sdsmt-robotics/power-distribution-board/README.md

# power-distribution-board
kicad files for a power distribution board
