sdsmt-robotics/power-distribution-board/Production/MinesRobotics_PDB.csv

Item | Qty | Reference(s) | Value | Footprint | MFN#
1 | 2 | C1, C7 | 10u | Capacitor_SMD:C_0603_1608Metric | GRM188R6YA106MA73D
2 | 1 | C2 | 0.1u | Capacitor_SMD:C_0603_1608Metric | CL10B104KB8WPND
3 | 2 | C3, C5 | 22u | Capacitor_Tantalum_SMD:CP_EIA-7343-15_Kemet-W | TCJD226M050R0090E
4 | 2 | C4, C8 | 1u | Capacitor_SMD:C_0603_1608Metric | CL10A105KB8NNNC
5 | 8 | D1, D2, D3, D4, D5, D6, D7, D8 | LED_Small | LED_SMD:LED_0805_2012Metric | LS R976-NR-1
6 | 16 | F1, F2, F3, F4, F5, F6, F7, F8, F9, F10, F11, F12, F13, F14, F15, F16 | Fuse | Fuse:Fuseholder_Blade_Mini_Keystone_3568 | 3568
8 | 1 | J1 | Conn_01x02_Female | Connector_JST:JST_XH_B2B-XH-A_1x02_P2.50mm_Vertical | B2B-XH-A(LF)(SN)
9 | 8 | J2, J3, J4, J5, J6, J7, J8, J9 | Conn_01x02_Female | AndersonPowerPole:PowerPole_45A_Vert
10 | 2 | R1, R2 | 100 | Resistor_SMD:R_0805_2012Metric | RMCF0805FT100R
11 | 8 | R3, R4, R5, R6, R7, R8, R9, R10 | 10k | Resistor_SMD:R_0805_2012Metric | RMCF0805JT100K
12 | 1 | RV1 | 50k | Potentiometer_THT:Potentiometer_Bourns_3266Y_Vertical | PV37W503C01B00
13 | 1 | U1 | I6A4W020A033V-003-R | PDB:i6A4W | I6A24014A033V-003-R
