sdsmt-robotics/power-distribution-board/3D Models/FullAssembly.FCStd

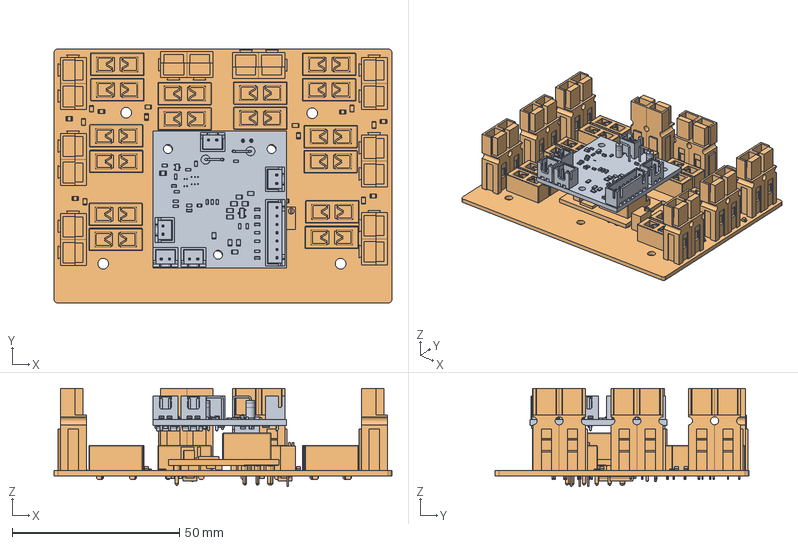
[picture p1: CAD file, 2022-02-20]
3D Models/FullAssembly.FCStd
101.1 x 75.9 x 29.4 mm
PowerBackup
PDB_PCB
