sdsmt-robotics/power-distribution-board/3D Models/PPAssembly.step

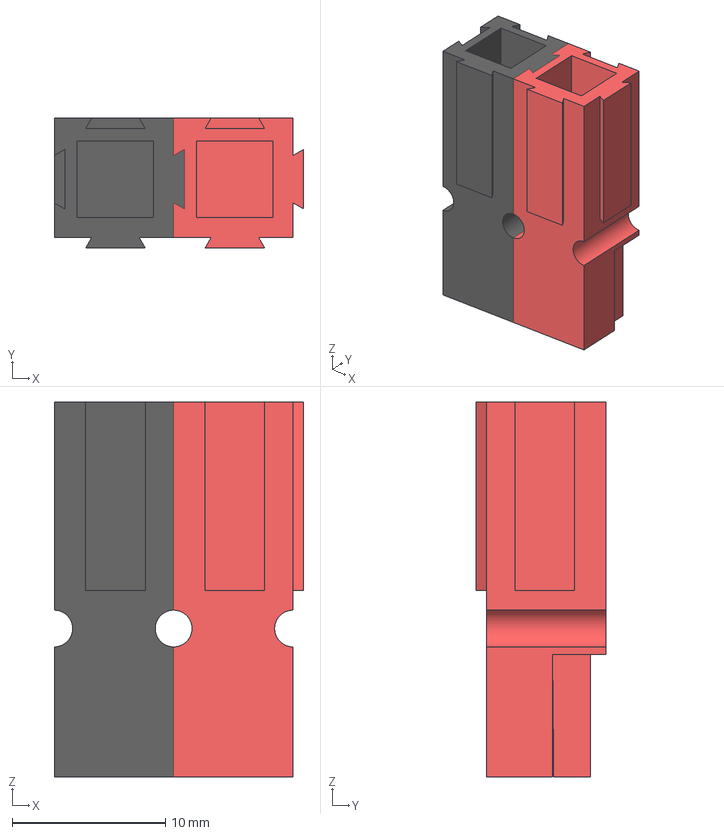
[picture p2: CAD file, 2022-02-14]
3D Models/PPAssembly.step
16.3 x 8.50 x 24.5 mm
pp_002
pp_001
