sdsmt-robotics/power-distribution-board/3D Models/i6a_fullfeature_step.stp

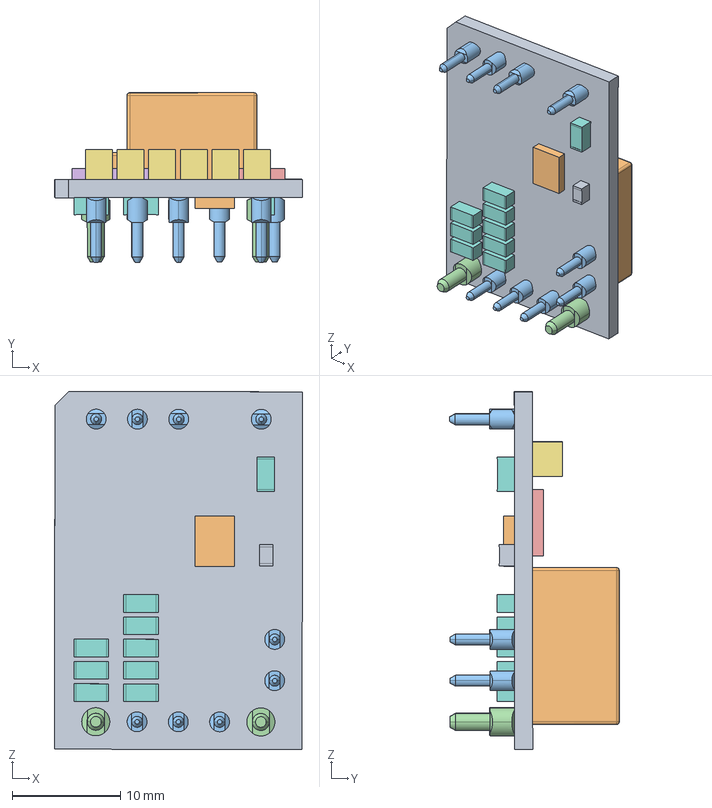
[picture p3: CAD file, 2022-02-13]
3D Models/i6a_fullfeature_step.stp
22.9 x 15.7 x 33.0 mm
I6A_PCB
I6A_OUTPUT_INDUCTOR
ZP00166_01- x 9
ZP00167_01- x 2
I6A_LOW_SIDE_FET
I6A_HIGH_SIDE_FET x 2
1210_CAP_COLOR x 6
1206_CAP_COLOR x 9
0805_CAP
I6A_CONTROL_IC2
