sdsmt-robotics/power-distribution-board/3D Models/BM04B-SRSS-TB-LF--SN---3DModel-STEP-56544.STEP

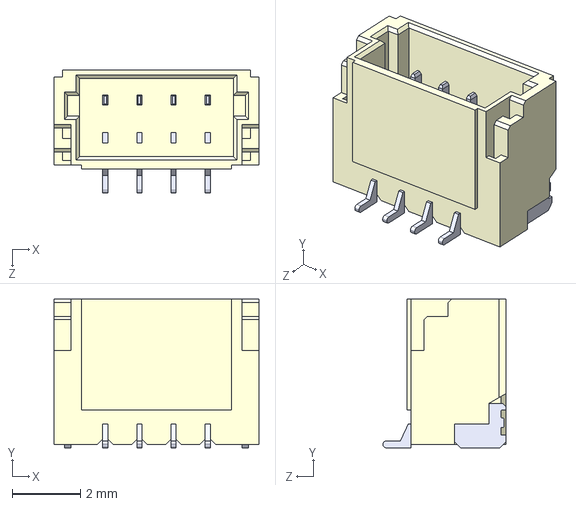
[picture p4: CAD file, 2022-02-21]
3D Models/BM04B-SRSS-TB-LF--SN---3DModel-STEP-56544.STEP
6.00 x 4.35 x 3.60 mm
