sdsmt-robotics/power-distribution-board/PowerBackup/PowerBackup.step

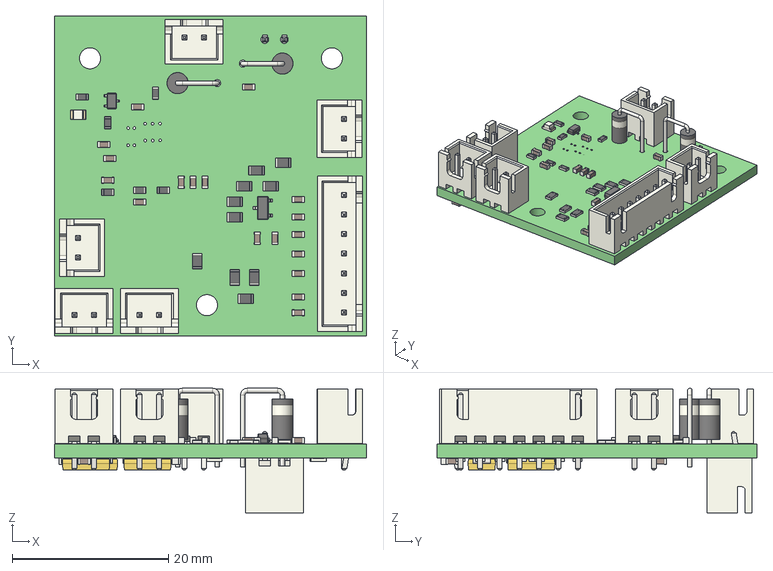
[picture p5: CAD file, 2022-02-20]
PowerBackup/PowerBackup.step
40.0 x 41.0 x 16.0 mm
PowerBackup PCB
