sdsmt-robotics/power-distribution-board/3D Models/Fuse - mini 30A.step

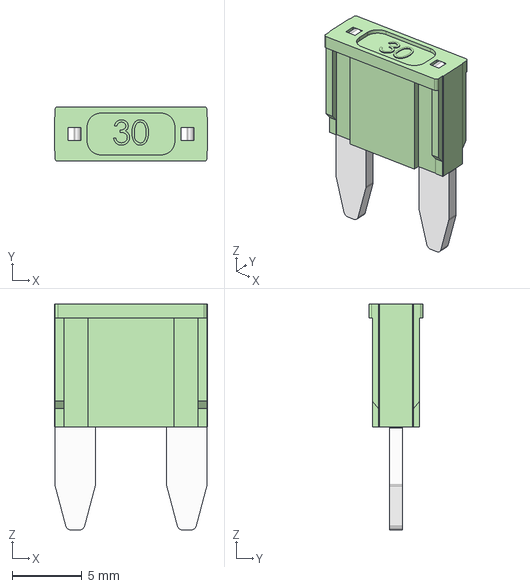
[picture p6: CAD file, 2022-02-10]
3D Models/Fuse - mini 30A.step
11.0 x 3.90 x 16.2 mm
