sdsmt-robotics/power-distribution-board/PowerBackup/PowerBackup.kicad_pcb

## KiCad design PowerBackup/PowerBackup.kicad_pcb (2022-03-16)

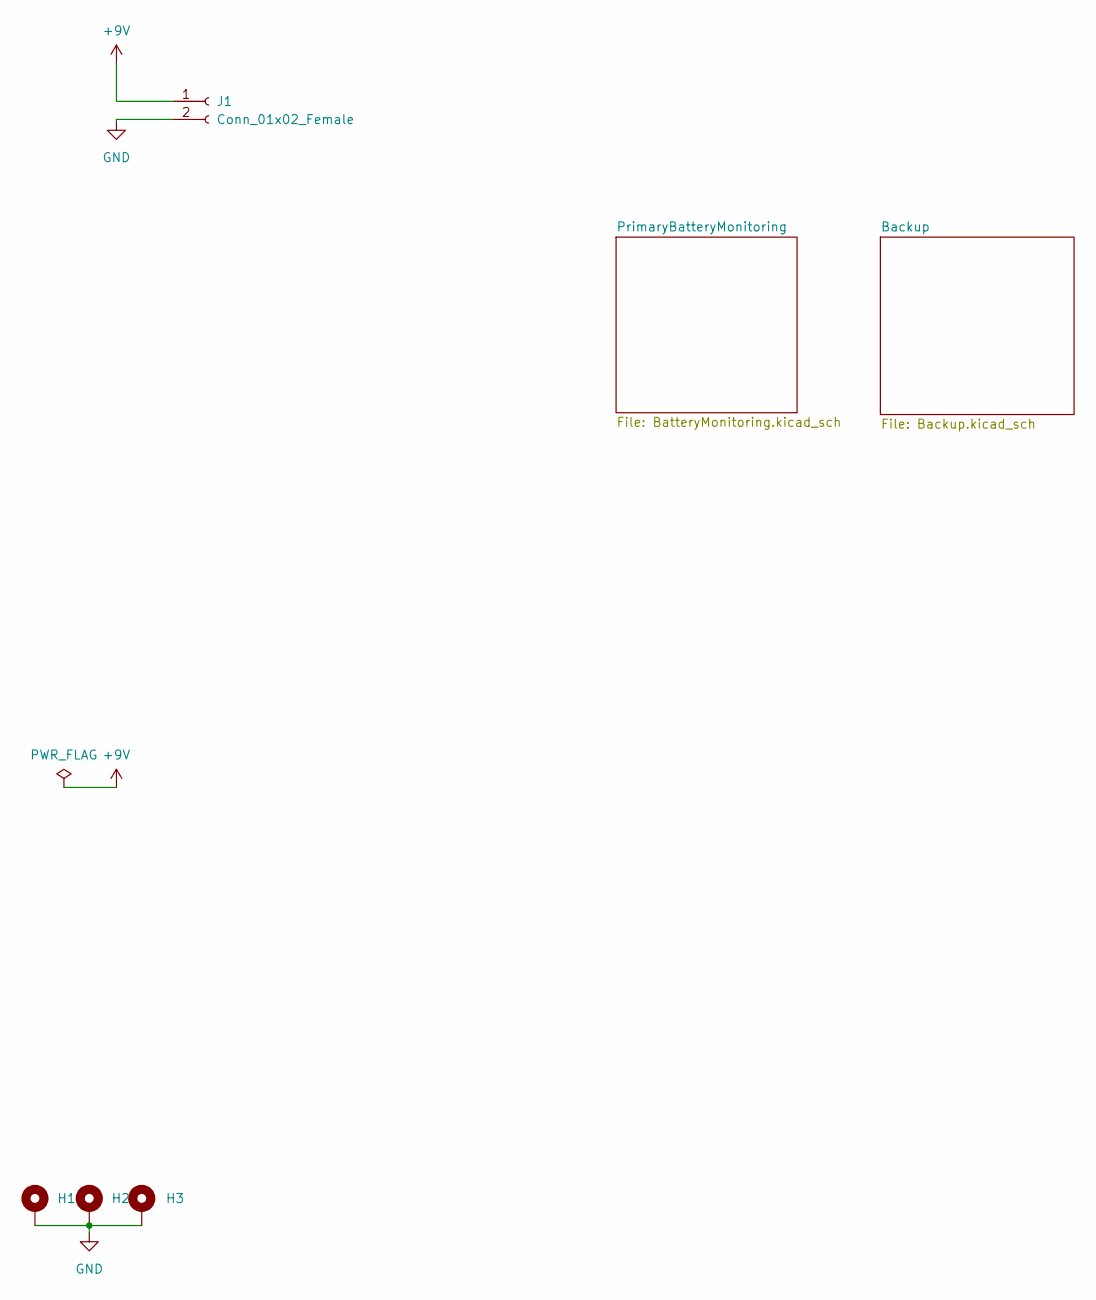
[picture p7: schematic PowerBackup.kicad_sch]

Parts:
H1, H2, H3: MountingHole_Pad; MountingHole_2.7mm_M2.5_Pad
J1: Conn_01x02_Female; JST_XH_B2B-XH-A_1x02_P2.50mm_Vertical

Connections:
+9V: J1.1; also elsewhere on the board
GND: H1.1, H2.1, H3.1, J1.2; also elsewhere on the board

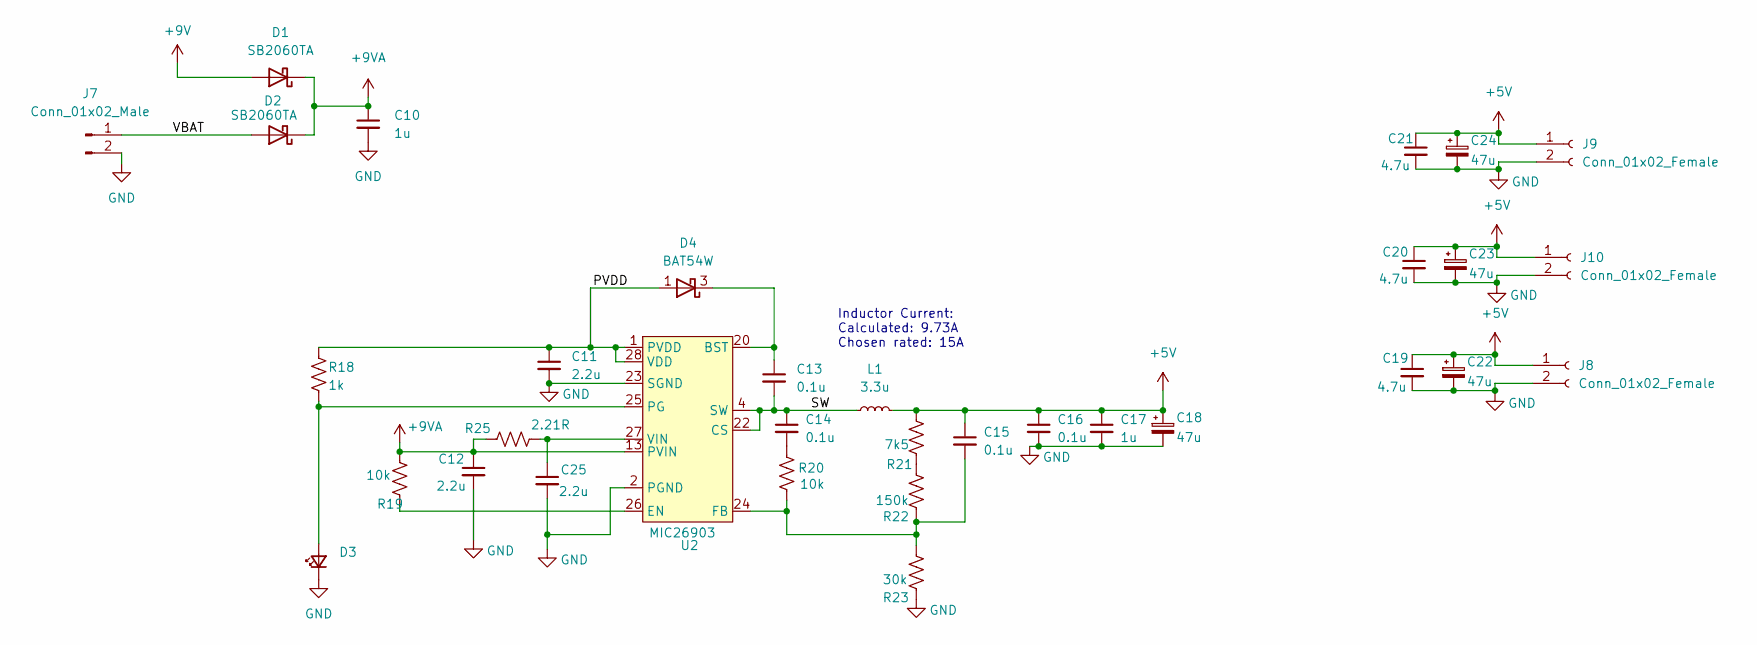
[picture p8: schematic Backup.kicad_sch]

Parts:
C10, C17: 1u; C_0603_1608Metric
C11, C12, C25: 2.2u; C_0603_1608Metric
C13, C14, C15, C16: 0.1u; C_0603_1608Metric
C18, C22, C23, C24: 47u; CP_EIA-6032-15_Kemet-U
C19, C20, C21: 4.7u; C_0603_1608Metric
D1, D2: SB2060TA; D_A-405_P5.08mm_Vertical_KathodeUp
D3: LED_Small; LED_0805_2012Metric
D4: BAT54W; SOT-323_SC-70
J7: Conn_01x02_Male; JST_XH_B2B-XH-A_1x02_P2.50mm_Vertical
J8, J9, J10: Conn_01x02_Female; JST_XH_B2B-XH-A_1x02_P2.50mm_Vertical
L1: 3.3u; Inductor_EXL1V0707-3R3-R
R18: 1k; R_0603_1608Metric
R19, R20: 10k; R_0603_1608Metric
R21: 7k5; R_0603_1608Metric
R22: 150k; R_0603_1608Metric
R23: 30k; R_0603_1608Metric
R25: 2.21R; R_0603_1608Metric
U2: MIC26903; MIC26903YJL-TR

Connections:
+5V: C15.1, C16.1, C17.1, C18.1, C19.1, C20.1, C21.1, C22.1, C23.1, C24.1, J8.1, J9.1, J10.1, L1.2, R21.1
+9V: D1.2 (A); also elsewhere on the board
+9VA: C10.1, C12.1, D1.1 (K), D2.1 (K), R19.1, R25.1, U2.13 (PVIN), U2.14 (PVIN), U2.15 (PVIN), U2.16 (PVIN), U2.17 (PVIN), U2.18 (PVIN), U2.19 (PVIN)
/Backup/PVDD: C11.1, D4.1 (A), R18.1, U2.1 (PVDD), U2.28 (VDD)
/Backup/SW: C13.2, C14.1, L1.1, U2.4 (SW), U2.9 (SW), U2.10 (SW), U2.11 (SW), U2.12 (SW), U2.22 (CS)
/Backup/VBAT: D2.2 (A), J7.1
GND: C10.2, C11.2, C12.2, C16.2, C17.2, C18.2, C19.2, C20.2, C21.2, C22.2, C23.2, C24.2, C25.2, D3.1 (K), J7.2, J8.2, J9.2, J10.2, R23.2, U2.2 (PGND), U2.5 (PGND), U2.6 (PGND), U2.7 (PGND), U2.8 (PGND), U2.21 (PGND), U2.23 (SGND); also elsewhere on the board
unnamed: C13.1, D4.3 (K), U2.20 (BST)
unnamed: C14.2, R20.1
unnamed: C15.2, R20.2, R22.2, R23.1, U2.24 (FB)
unnamed: C25.1, R25.2, U2.27 (VIN)
unnamed: D3.2 (A), R18.2, U2.25 (PG)
unnamed: R19.2, U2.26 (EN)
unnamed: R21.2, R22.1

Notes on the sheet:
Inductor Current: Calculated: 9.73A Chosen rated: 15A

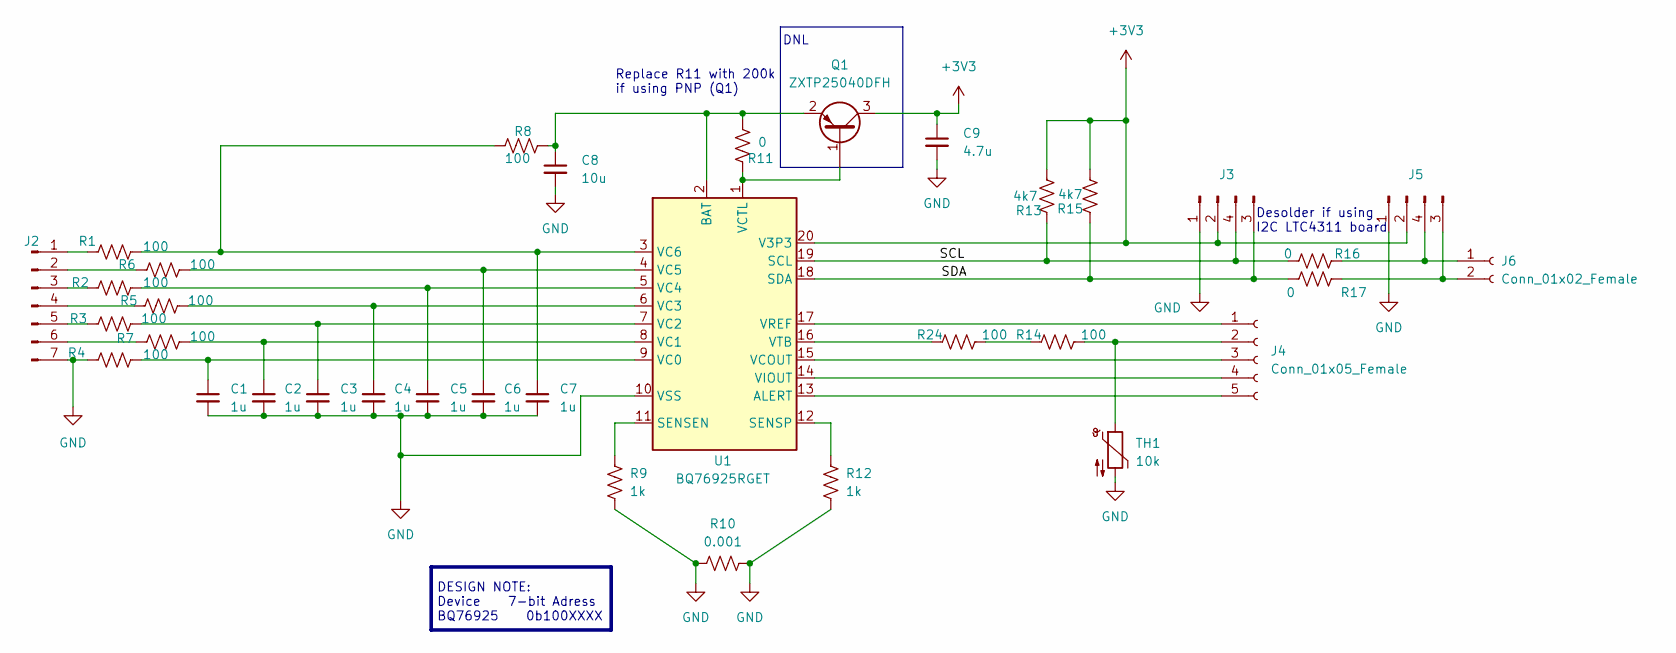
[picture p9: schematic BatteryMonitoring.kicad_sch]

Parts:
C1, C2, C3, C4, C5, C6, C7: 1u; C_0603_1608Metric
C8: 10u; C_0603_1608Metric
C9: 4.7u; C_0603_1608Metric
J2: Conn_01x07_Male; JST_XH_B7B-XH-A_1x07_P2.50mm_Vertical
J3, J5: Conn_01x04_Male; JST_SH_BM04B-SRSS-TB_1x04-1MP_P1.00mm_Vertical
J4: Conn_01x05_Female; PinHeader_1x05_P1.00mm_Vertical_SMD_Pin1Left
J6: Conn_01x02_Female; JST_XH_B2B-XH-A_1x02_P2.50mm_Vertical
Q1: ZXTP25040DFH; SOT-23
R1, R2, R3, R4, R5, R6, R7, R8, R14, R24: 100; R_0805_2012Metric
R9, R12: 1k; R_0603_1608Metric
R10: 0.001; R_0805_2012Metric
R11, R16, R17: 0; R_0805_2012Metric
R13, R15: 4k7; R_0805_2012Metric
TH1: 10k; R_0805_2012Metric
U1: BQ76925RGET; HVQFN-24-1EP_4x4mm_P0.5mm_EP2.5x2.5mm

Connections:
+3V3: C9.1, J3.2, J5.2, Q1.3 (C), R13.2, R15.2, U1.20 (V3P3)
/PrimaryBatteryMonitoring/SCL: J3.4 (Pin_3), R13.1, R16.2, U1.19 (SCL)
/PrimaryBatteryMonitoring/SDA: J3.3 (Pin_4), R15.1, R17.2, U1.18 (SDA)
GND: C1.2, C2.2, C3.2, C4.2, C5.2, C6.2, C7.2, C8.2, C9.2, J2.7, J3.1, J5.1, R4.1, R9.2, R10.1, R10.2, R12.2, TH1.2, U1.10 (VSS); also elsewhere on the board
unnamed: C1.1, R4.2, U1.9 (VC0)
unnamed: C2.1, R7.2, U1.8 (VC1)
unnamed: C3.1, R3.2, U1.7 (VC2)
unnamed: C4.1, R5.2, U1.6 (VC3)
unnamed: C5.1, R2.2, U1.5 (VC4)
unnamed: C6.1, R6.2, U1.4 (VC5)
unnamed: C7.1, R1.2, R8.1, U1.3 (VC6)
unnamed: C8.1, Q1.2 (E), R8.2, R11.2, U1.2 (BAT)
unnamed: J2.1, R1.1
unnamed: J2.2, R6.1
unnamed: J2.3, R2.1
unnamed: J2.4, R5.1
unnamed: J2.5, R3.1
unnamed: J2.6, R7.1
unnamed: J4.1, U1.17 (VREF)
unnamed: J4.2, R14.2, TH1.1
unnamed: J4.3, U1.15 (VCOUT)
unnamed: J4.4, U1.14 (VIOUT)
unnamed: J4.5, U1.13 (ALERT)
unnamed: J5.3 (Pin_4), J6.2, R17.1
unnamed: J5.4 (Pin_3), J6.1, R16.1
unnamed: Q1.1 (B), R11.1, U1.1 (VCTL)
unnamed: R9.1, U1.11 (SENSEN)
unnamed: R12.1, U1.12 (SENSP)
unnamed: R14.1, R24.2
unnamed: R24.1, U1.16 (VTB)

Notes on the sheet:
Desolder if using I2C LTC4311 board
DNL
Replace R11 with 200k if using PNP (Q1)
DESIGN NOTE: Device 7-bit Adress BQ76925 0b100XXXX

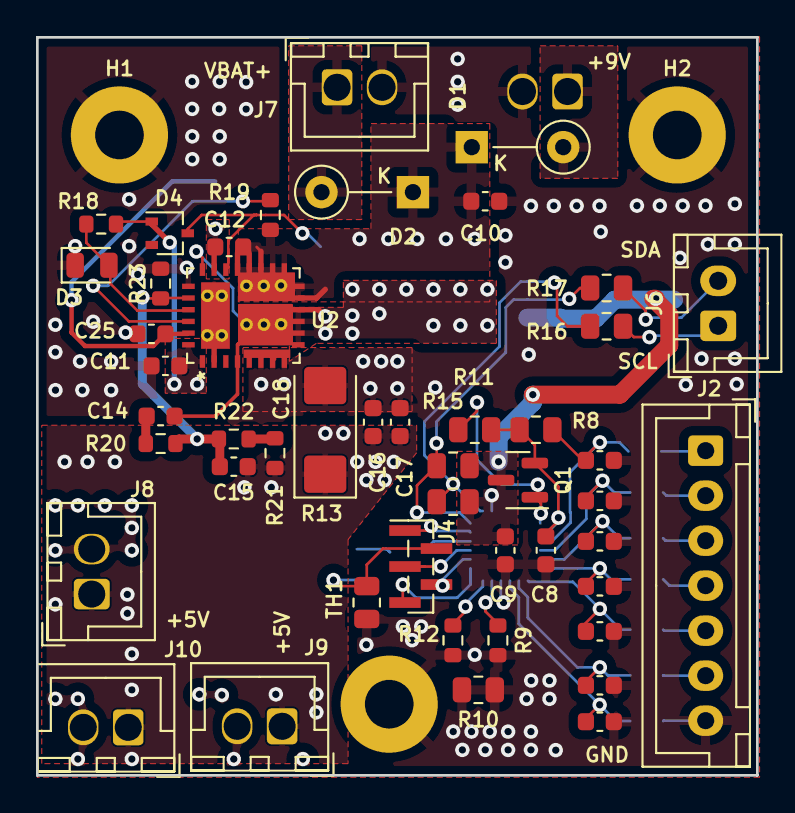
[picture p10: board PowerBackup.kicad_pcb from above]

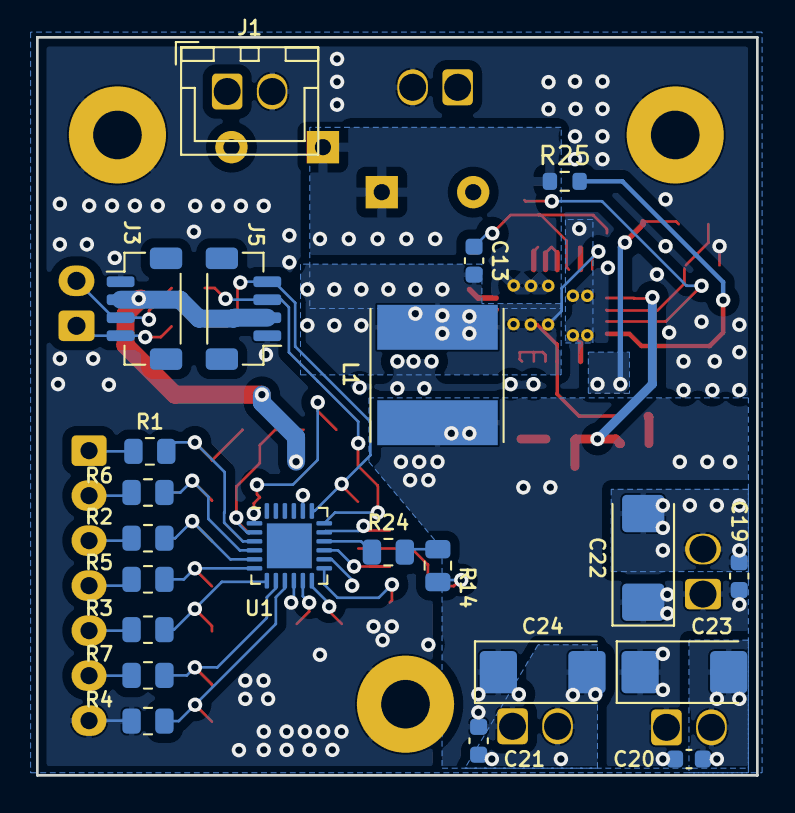
[picture p11: board PowerBackup.kicad_pcb from below]

Board: 4 copper layers, 40.0 x 41.0 mm, 72 parts (22 on the bottom side), 43 nets.
