sdsmt-robotics/power-distribution-board/MinesRobotics_PDB.kicad_pcb

## KiCad design MinesRobotics_PDB.kicad_pcb (2022-03-16)

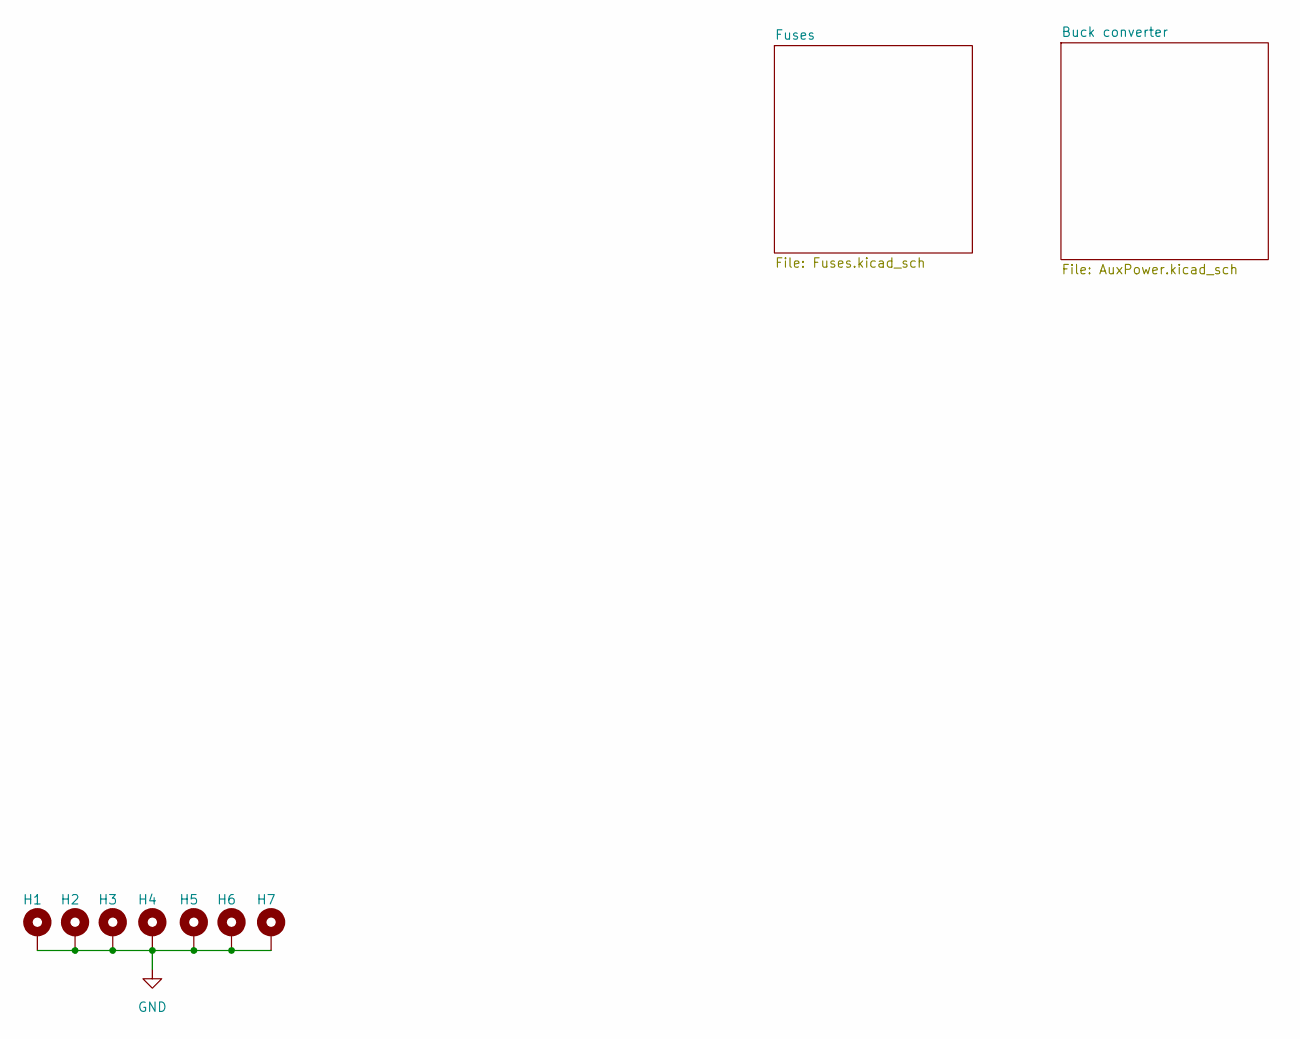
[picture p12: schematic MinesRobotics_PDB.kicad_sch]

Parts:
H1, H2, H3, H4, H5, H6, H7: MountingHole_Pad; MountingHole_3.2mm_M3_DIN965_Pad

Connections:
GND: H1.1, H2.1, H3.1, H4.1, H5.1, H6.1, H7.1; also elsewhere on the board

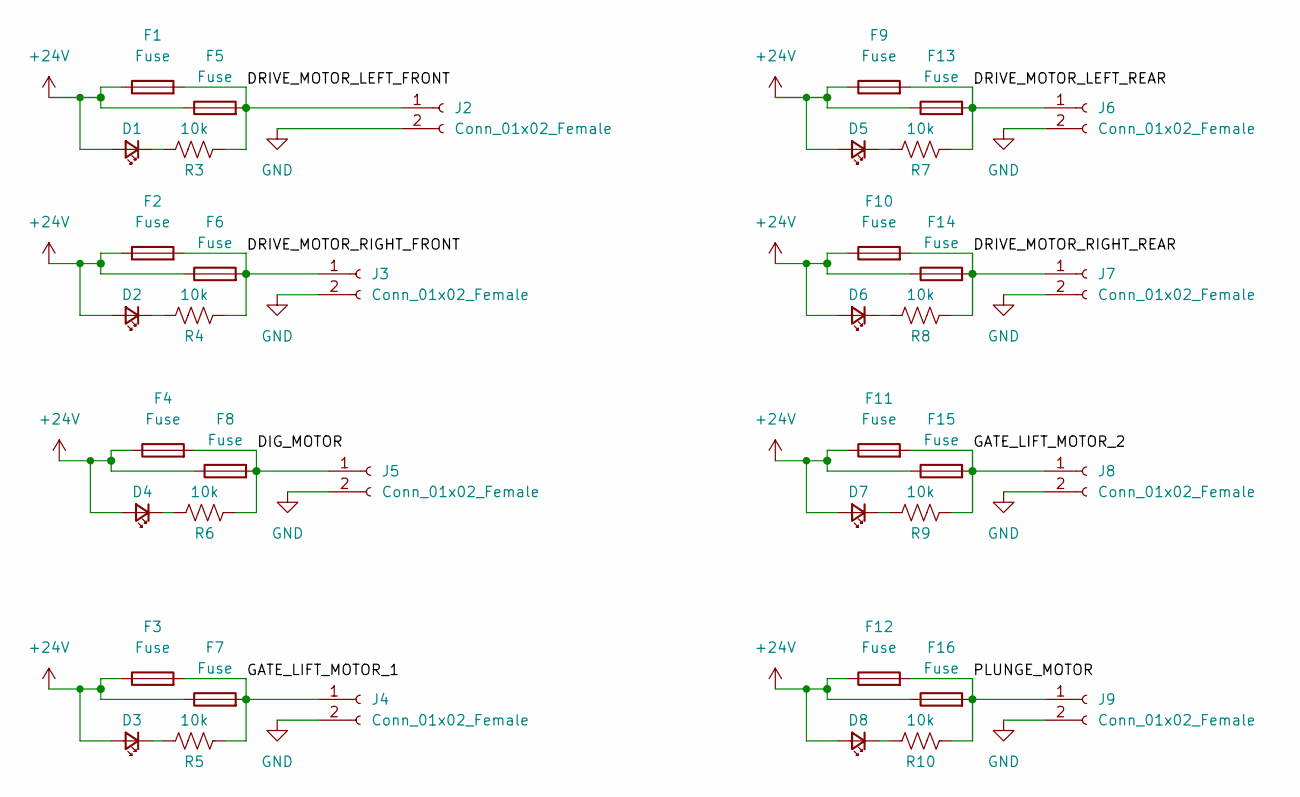
[picture p13: schematic Fuses.kicad_sch]

Parts:
D1, D2, D3, D4, D5, D6, D7, D8: LED_Small; LED_0805_2012Metric
F1, F2, F3, F4, F5, F6, F7, F8, F9, F10, F11, F12, F13, F14, F15, F16: Fuse; Fuseholder_Blade_Mini_Keystone_3568
J2, J3, J4, J5, J6, J7, J8, J9: Conn_01x02_Female; PowerPole_45A_Vert
R3, R4, R5, R6, R7, R8, R9, R10: 10k; R_0805_2012Metric

Connections:
+24V: D1.2 (A), D2.2 (A), D3.2 (A), D4.2 (A), D5.2 (A), D6.2 (A), D7.2 (A), D8.2 (A), F1.1, F2.1, F3.1, F4.1, F5.1, F6.1, F7.1, F8.1, F9.1, F10.1, F11.1, F12.1, F13.1, F14.1, F15.1, F16.1; also elsewhere on the board
/Fuses/DIG_MOTOR: F4.2, F8.2, J5.1, R6.2
/Fuses/DRIVE_MOTOR_LEFT_FRONT: F1.2, F5.2, J2.1, R3.2
/Fuses/DRIVE_MOTOR_LEFT_REAR: F9.2, F13.2, J6.1, R7.2
/Fuses/DRIVE_MOTOR_RIGHT_FRONT: F2.2, F6.2, J3.1, R4.2
/Fuses/DRIVE_MOTOR_RIGHT_REAR: F10.2, F14.2, J7.1, R8.2
/Fuses/GATE_LIFT_MOTOR_1: F3.2, F7.2, J4.1, R5.2
/Fuses/GATE_LIFT_MOTOR_2: F11.2, F15.2, J8.1, R9.2
/Fuses/PLUNGE_MOTOR: F12.2, F16.2, J9.1, R10.2
GND: J2.2, J3.2, J4.2, J5.2, J6.2, J7.2, J8.2, J9.2; also elsewhere on the board
unnamed: D1.1 (K), R3.1
unnamed: D2.1 (K), R4.1
unnamed: D3.1 (K), R5.1
unnamed: D4.1 (K), R6.1
unnamed: D5.1 (K), R7.1
unnamed: D6.1 (K), R8.1
unnamed: D7.1 (K), R9.1
unnamed: D8.1 (K), R10.1

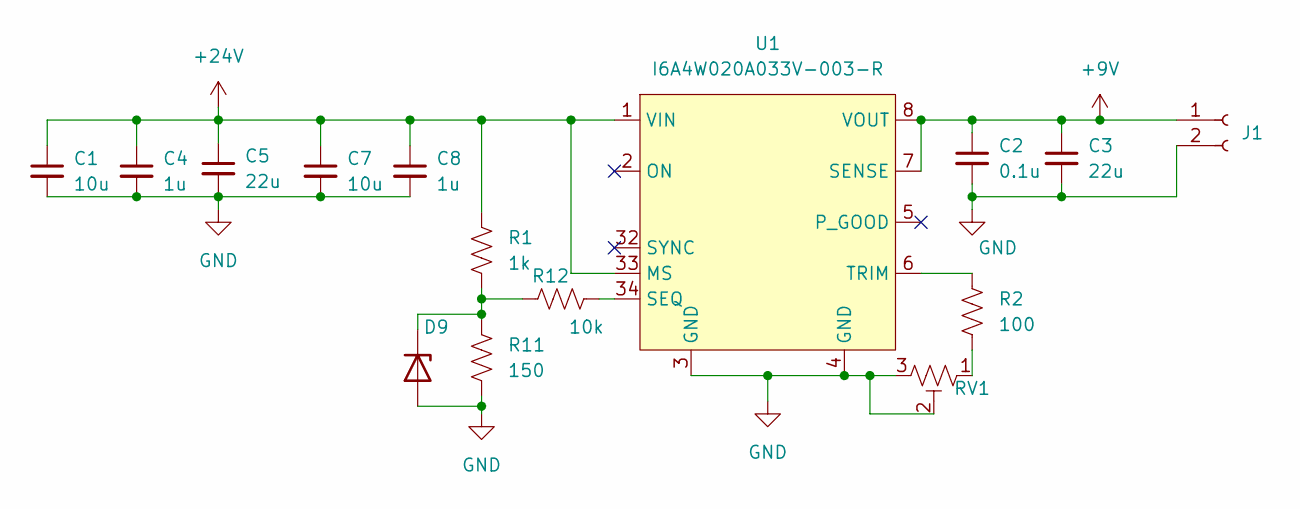
[picture p14: schematic AuxPower.kicad_sch]

Parts:
C1, C7: 10u; C_0603_1608Metric
C2: 0.1u; C_0603_1608Metric
C3, C5: 22u; CP_EIA-7343-15_Kemet-W
C4, C8: 1u; C_0603_1608Metric
D9: BZX8450-C2V2VL; SOT-23
J1: Conn_01x02_Female; JST_XH_B2B-XH-A_1x02_P2.50mm_Vertical
R1: 1k; R_0805_2012Metric
R2: 100; R_0805_2012Metric
R11: 150; R_0805_2012Metric
R12: 10k; R_0805_2012Metric
RV1: 50k; Potentiometer_Bourns_3266Y_Vertical
U1: I6A4W020A033V-003-R; i6A4W

Connections:
+9V: C2.1, C3.1, J1.1, U1.7 (SENSE), U1.8 (VOUT)
+24V: C1.1, C4.1, C5.1, C7.1, C8.1, R1.1, U1.1 (VIN), U1.33 (MS); also elsewhere on the board
GND: C1.2, C2.2, C3.2, C4.2, C5.2, C7.2, C8.2, D9.1 (A), J1.2, R11.2, RV1.2, RV1.3, U1.3 (GND), U1.4 (GND); also elsewhere on the board
unnamed: D9.3 (K), R1.2, R11.1, R12.1
unnamed: R2.1, U1.6 (TRIM)
unnamed: R2.2, RV1.1
unnamed: R12.2, U1.34 (SEQ)

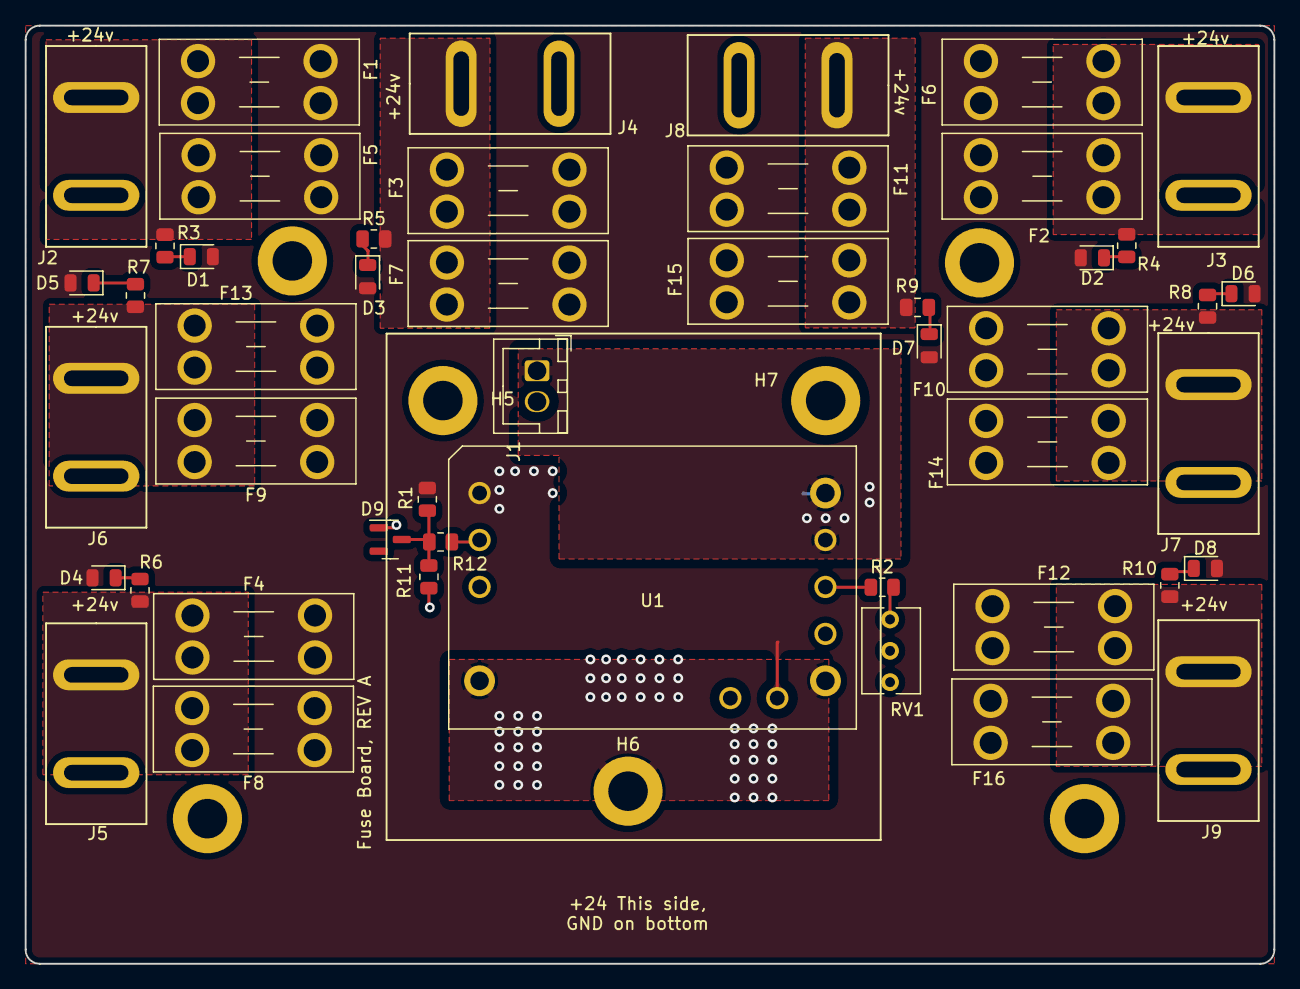
[picture p15: board MinesRobotics_PDB.kicad_pcb from above]

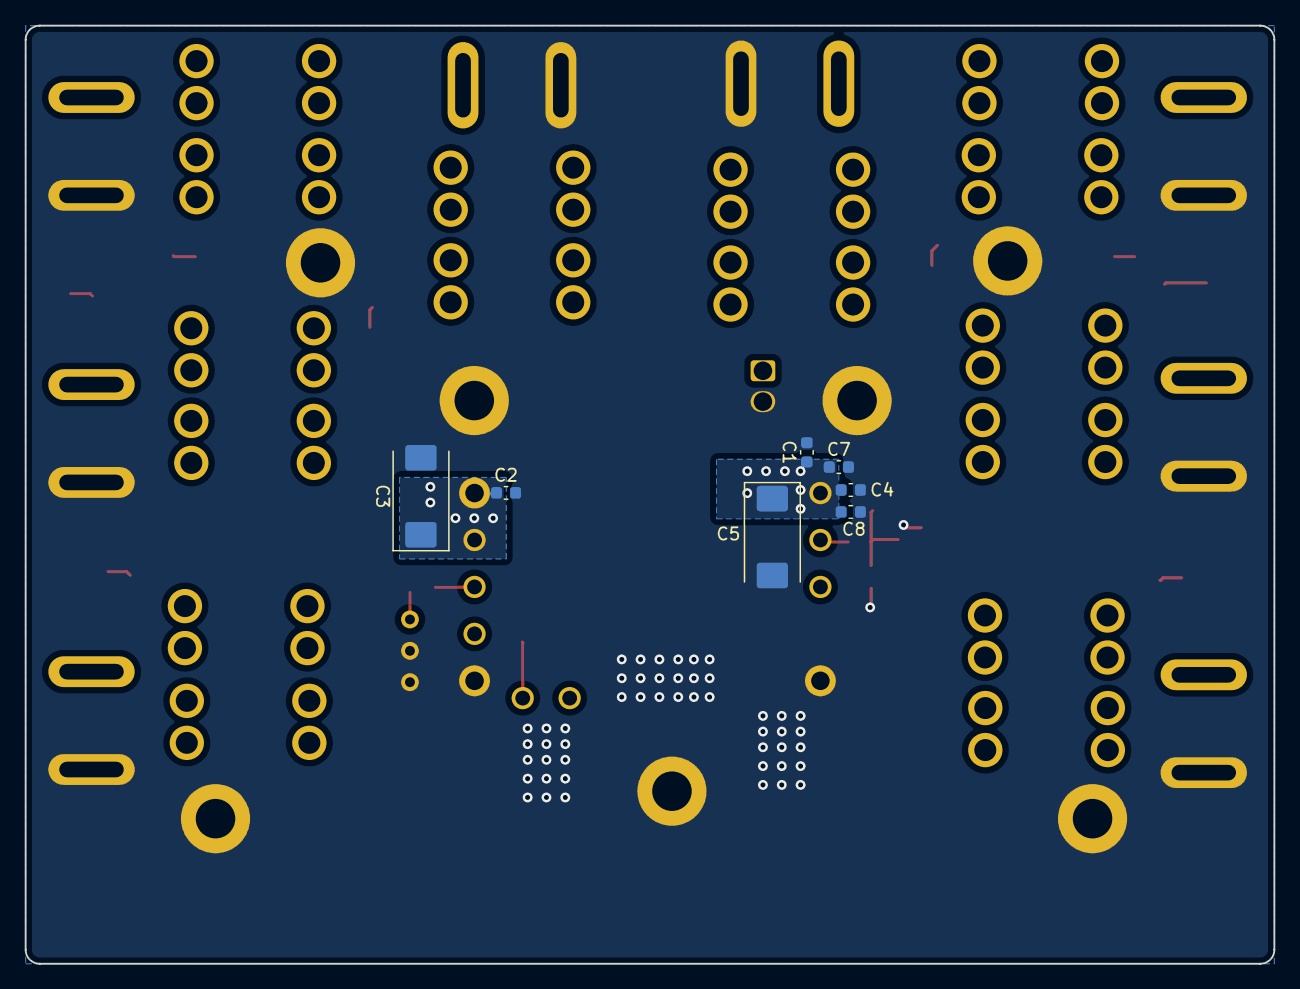
[picture p16: board MinesRobotics_PDB.kicad_pcb from below]

Board: 2 copper layers, 101.1 x 75.9 mm, 62 parts (7 on the bottom side), 23 nets.
