sdsmt-robotics/power-distribution-board/(commit log)

2022-02-04 Adding old kicad files
    [MinesRobotics_PDB-B.Cu.gbl, MinesRobotics_PDB-B.Mask.gbs, MinesRobotics_PDB-B.Paste.gbp, MinesRobotics_PDB-B.SilkS.gbo, MinesRobotics_PDB-Edge.Cuts.gm1, MinesRobotics_PDB-F.Cu.gtl, MinesRobotics_PDB-F.Mask.gts, MinesRobotics_PDB-F.Paste.gtp]
2022-02-12 Updated according to requirements
    [AuxPower.kicad_sch, Fuses.kicad_sch, Low_side_FET.kicad_sch, MinesRobotics_PDB.kicad_pcb]
2022-02-13 Added 9V buck converter
    [AuxPower.kicad_sch, Fuses.kicad_sch, MinesRobotics_PDB.kicad_pcb, MinesRobotics_PDB.kicad_sch, i6a_fullfeature_step.stp]
2022-02-13 Cleaning up for prototype run
    [9771130360R (rev1).stp, AuxPower.kicad_sch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]
2022-02-13 Still cleaning up
    [MinesRobotics_PDB.kicad_pcb]
2022-02-13 Added schematic and PCB pdf's
2022-02-14 No point using Fuses w/o fuse holders, Also added 3D models
    [9771130360R (rev1).stp, AuxPower.kicad_sch, Fuses.kicad_sch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]
2022-02-14 Added BOM and updated Cap footprint according to availability
    [AuxPower.kicad_sch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]
2022-02-16 starting Backup board and updated 3D model
    [BatteryMonitoring.kicad_sch, PowerBackup.kicad_pcb, PowerBackup.kicad_sch]
2022-02-17 Changed resistors and LEDs to 0805 and updated Production files
    [AuxPower.kicad_sch, BatteryMonitoring.kicad_sch, Connectors.kicad_sch, Fuses.kicad_sch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]
2022-02-17 Did some initial board layout
    [Backup.kicad_sch, BatteryMonitoring.kicad_sch, Connectors.kicad_sch, MinesRobotics_PDB.kicad_pcb, PowerBackup.kicad_pcb, PowerBackup.kicad_sch]
2022-02-17 Trying things
    [Backup.kicad_sch, BatteryMonitoring.kicad_sch, FullAssembly.FCStd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]
2022-02-19 Adding regulator
    [Backup.kicad_sch, BatteryMonitoring.kicad_sch, PowerBackup.kicad_sch]
2022-02-19 Moved daughter board up a tiny bit
    [MinesRobotics_PDB.csv, MinesRobotics_PDB.kicad_pcb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]
2022-02-20 Added 5V 9A buck converter
    [AuxPower.kicad_sch, Backup.kicad_sch, BatteryMonitoring.kicad_sch, FullAssembly.FCStd, MinesRobotics_PDB.kicad_sch, PowerBackup.kicad_pcb, PowerBackup.kicad_sch, PowerBackup.step]
2022-02-20 Looking over desing
    [Backup.kicad_sch, BatteryMonitoring.kicad_sch, PowerBackup.kicad_pcb, PowerBackup.kicad_sch]
2022-02-21 Added Qwiic connector
    [BM04B-SRSS-TB-LF--SN---3DModel-STEP-56544.STEP, PowerBackup.kicad_pcb]
2022-02-21 fixed 9V regulator circuit
    [AuxPower.kicad_sch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]
2022-02-21 Adding production files for power backup
    [PowerBackup-B_Cu.gbr, PowerBackup-B_Mask.gbr, PowerBackup-B_Paste.gbr, PowerBackup-B_Silkscreen.gbr, PowerBackup-Edge_Cuts.gbr, PowerBackup-F_Cu.gbr, PowerBackup-F_Mask.gbr, PowerBackup-F_Paste.gbr]
2022-03-01 Added BOM and production files
    [Backup.kicad_sch, BatteryMonitoring.kicad_sch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]
2022-03-13 Pvin is connected to Vin through a 2.21R resistor
    [Backup.kicad_sch, BatteryMonitoring.kicad_sch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]
2022-03-15 Updating production files
    [PowerBackup-B_Cu.gbr, PowerBackup-B_Fab.gbr, PowerBackup-B_Mask.gbr, PowerBackup-B_Paste.gbr, PowerBackup-B_Silkscreen.gbr, PowerBackup-Edge_Cuts.gbr, PowerBackup-F_Cu.gbr, PowerBackup-F_Fab.gbr]
2022-03-16 Commiting before order, Regenerated gerbers for both boards
    [Backup.kicad_sch, BatteryMonitoring.kicad_sch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]
